RicardoBalderrabano/Aeropendulum/PID_2/PID_2.ioc

Mcu.UserName=STM32F446RETx
PA13.GPIO_Label=TMS
PA13.Signal=SYS_JTMS-SWDIO
PA14.GPIO_Label=TCK
PA14.Signal=SYS_JTCK-SWCLK
PA2.GPIO_Label=USART_TX
PA2.Signal=USART2_TX
PA3.GPIO_Label=USART_RX
PA3.Signal=USART2_RX
PA5.GPIO_Label=LD2 [Green Led]
PA5.Signal=GPIO_Output
PB3.GPIO_Label=SWO
PB3.Signal=SYS_JTDO-SWO
PB8.Signal=I2C1_SCL
PB9.Signal=I2C1_SDA
PC13.GPIO_Label=B1 [Blue PushButton]
PC13.Signal=GPXTI13
PC14-OSC32_IN.Signal=RCC_OSC32_IN
PC15-OSC32_OUT.Signal=RCC_OSC32_OUT
PH0-OSC_IN.Signal=RCC_OSC_IN
PH1-OSC_OUT.Signal=RCC_OSC_OUT
